silabs-CongD/z_wave_test/.github/project_info/README.md

# This folder will save information of the projects #

# Guide for TOC Hardware driver
    # Hardware driver
    toc_data['detail_name'] = 'your_input'
    toc_data['hw_driver_class'] = ''
    toc_data['third_party_board'] = ''
    toc_data['application_example'] = 'your_input'

# Guide for TOC Wireless Use case and TOC Market segment
    # Wireless usecase
    toc_data['detail_name'] = 'your_input'
    toc_data['embed_to_embed'] = 'Yes/No'
    toc_data['embed_to_gw'] = 'Yes/No'
    toc_data['embed_to_mobile'] = 'Yes/No'
    toc_data['wireless_tech'] = ''

    # Market segment
    toc_data['application'] = 'your_input'
    toc_data['market_segment'] = 'your_input'
