silabs-CongD/z_wave_test/z_wave_contact_sensor_application/docs/ZGM130S-SENSORS_DESIGN/Schematic/ZGM130-SENSORS_DESIGN_BOM.xlsx

ZGM130S based Contact Sensor Reference Design Revised: Friday, April 05, 2019
Revision: 1.0
Bill Of Materials April 5,2019 11:14:35
Item | Quantity | Reference | Value | Manufacturer | PartNumber | Footprint | Tolerance | Rating | Type | Not Installed
1 | 1 | ANT1 | ANT1204F005R0915A | Yageo | ANT1204F005R0915A | ANT1204 |  | 1W | ANTENNA
2 | 1 | BH1 | 20mm COIN | HUAI YANG CO., LTD | BS-06-BAA4002 | BAT-HLDR-2032-BS-06-B4AA002 |  |  | BATTERY_HOLDER
3 | 3 | C18 C20 C115 | 0.1uF | Venkel | C0402X7R100-104K | C0402 | ±10% |  | X7R
4 | 1 | C19 | 100uF | Kemet | T491D107K010AT | C7343D | ±10% |  | TANT
5 | 1 | C21 | 0.01uF | MuRata | GRM155R71H103KA88D | C0402 | ±10% |  | X7R
6 | 1 | C22 | 8pF | Venkel | C0402C0G250-8R0CNE | C0402 | ±0.25pF |  | C0G
7 | 1 | C23 | 4.7uF | Venkel | C0603X5R6R3-475K | C0603 | ±10% |  | X5R
8 | 1 | C24 | 56pF | MuRata | GRM1555C1H560GA01D | C0402 | ±2% |  | C0G
9 | 2 | C110 C112 | 10uF | Murata | ZRB18AD71A106KE01L | C0603 | ±10% |  | X7T
10 | 1 | C114 | 0.1uF | Murata | GRM155R71A104KA01D | C0402 | ±10% |  | X7R
11 | 1 | D1 | SUPER RED | EVERLIGHT ELECTRONICS CO.,LTD. | 19-21SURC/S530-XX/TR8 | LED-0603 |  | 25mA | SMT
12 | 1 | J1 | Header 2x5 .05in | Samtec | FTSH-105-01-F-DV-K | CONN2X5-FTS |  |  | Header
13 | 1 | M1 | SSM3J328R,LF | Toshiba | SSM3J328R,LF | SOT23-GSD |  | -6.0A | P-CHNL
14 | 2 | R4 R218 | 120 | Venkel | CR0402-16W-1200F | R0402 | ±1% | 1/16W | ThickFilm
15 | 1 | R5 | 287 | Venkel | CR0402-16W-2870F | R0402 | ±1% | 1/16W | ThickFilm
16 | 1 | R9 | 1K | Venkel | CR0402-16W-1001F | R0402 | ±1% | 1/16W | ThickFilm | NI
17 | 2 | R211 R212 | 0 | Venkel | CR0402-16W-000 | R0402 |  | 1A | ThickFilm | NI
18 | 1 | R214 | 0 | Venkel | CR0402-16W-000 | R0402 |  | 1A | ThickFilm
19 | 2 | R215 R216 | 10K | Venkel | CR0402-16W-103J | R0402 | ±5% | 1/16W | ThickFilm
20 | 1 | SW1 | SW_SLIDE_2POS | C&K | AYZ0202AGRLC | SW-DPDT-AYZ0202AGRLC |  | 100mA @ 12V | SLIDE
21 | 1 | SW2 | SW REED-NO | RYAZAN METAL CERAMICS INSTRUMENTAYION PLANT, JSC | MKA-14103 | SW-MKA-14103 |  | 500mA | REED | NI
22 | 1 | S1 | DS-A40-AU | Dawning Precision Co.,Ltd | DS-A40-AU | SW-DS-A40 |  | 1mA | Detector switch
23 | 1 | S2 | TS-A00-2-S076 | Dawning Precision Co., Ltd | TS-A00-2-S076 | SW-TS-A00-2-S076 |  | 50mA | Tactile
24 | 11 | TP1 TP11 TP12 TP13 TP14 TP15 TP16 TP17 TP18 TP25 TP0 | TPV | N/A | N/A | VIA-TP |  |  | PCB Feature
25 | 1 | U4 | Si7021 | SiLabs | SI7021-A20-IM1 | DFN6M3X3P1.0E |  |  | Humidity and Temperature
26 | 1 | U5 | ZGM130S037HGN1 | SiLabs | ZGM130S037HGN1R | LGA64M9X9P0.5 |  |  | MCU
27 | 1 | U6 | Si7210-B-00 | SiLabs | Si7210-B-00-IV(R) | SOT5N2.8P0.95 |  |  | Hall Effect
