silabs-CongD/z_wave_test/z_wave_contact_sensor_application/docs/ZGM130S-SENSORS_DESIGN/Schematic/zgm130s-sensors_design2.pdf

Initial design.

# Revision History

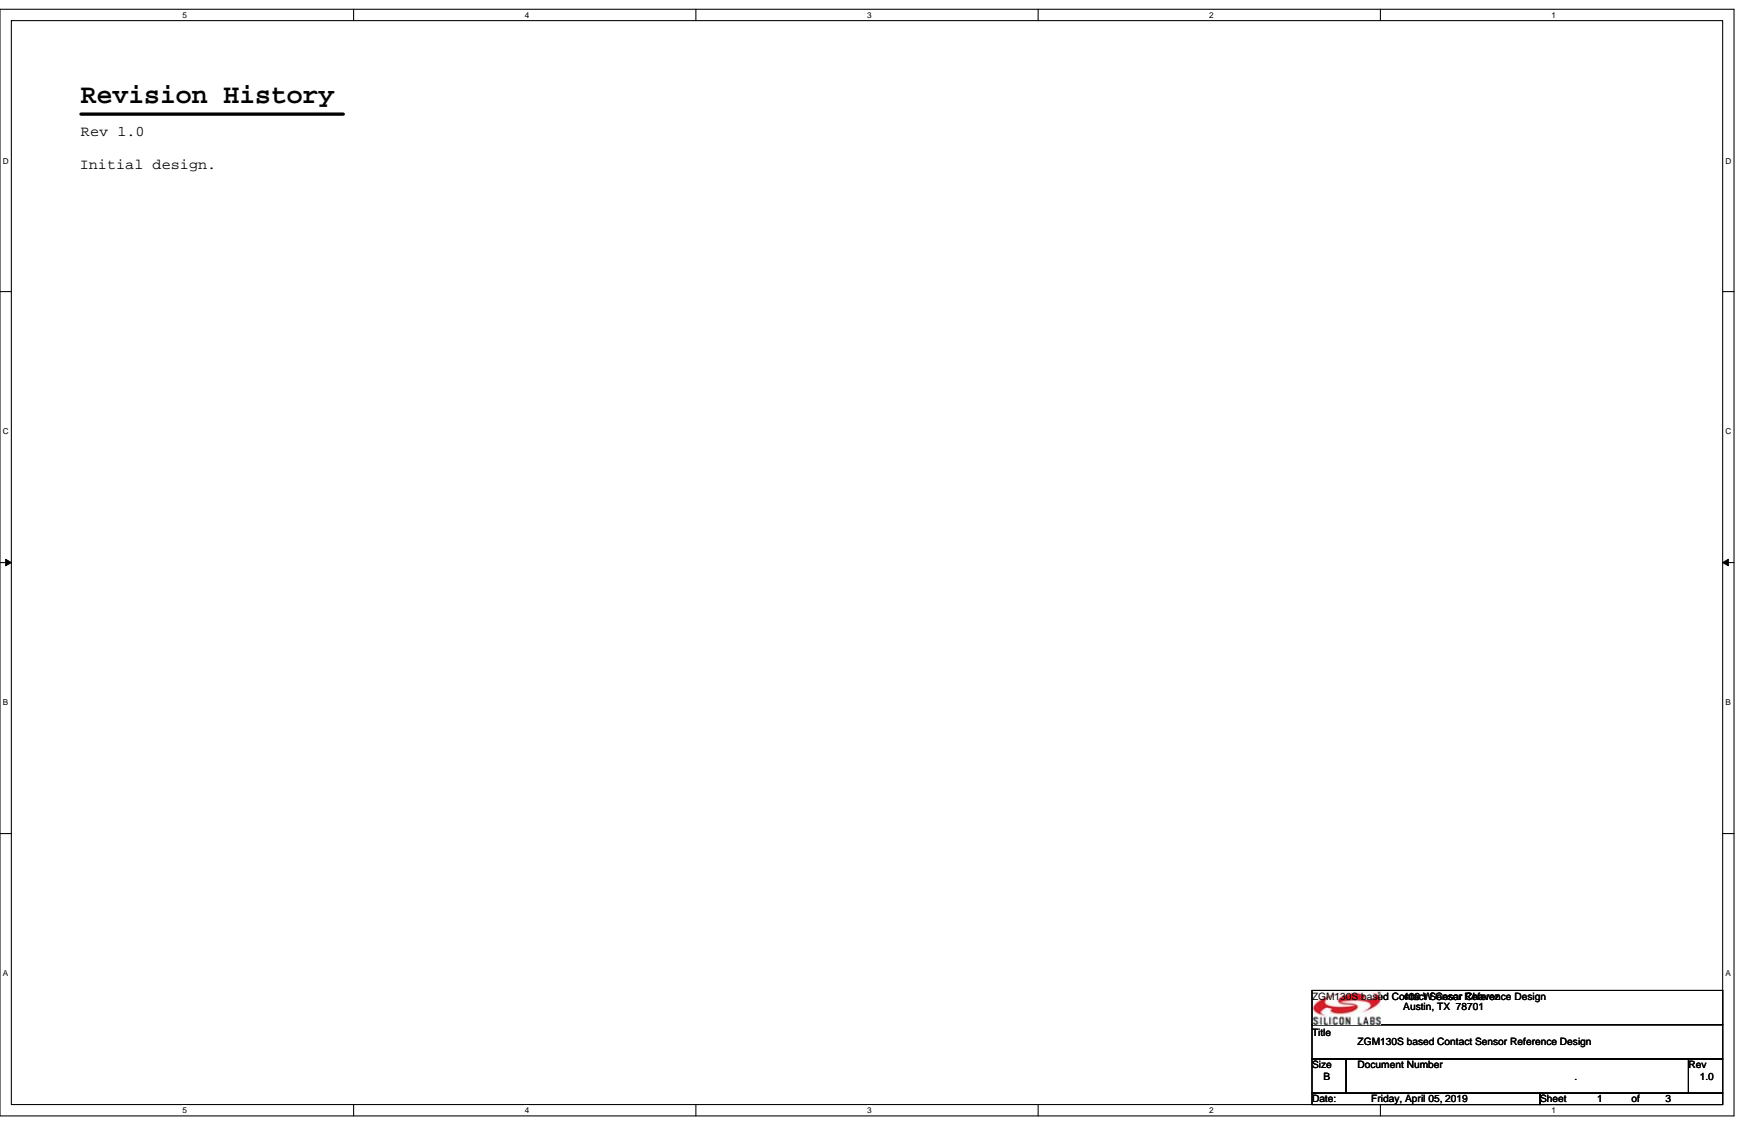
[picture p5: page 1]
Rev 1.0; Title; 400 W Cesar Chavez Austin, TX 78701

ZGM130S based Contact Sensor Reference Design

Size Size Size B B B | Document Number Document Number Document Number . . . | Rev Rev Rev 1.0 1.0 1.0

Date: Date: Date: Friday, April 05, 2019 Friday, April 05, 2019 Friday, April 05, 2019 | Sheet Sheet Sheet 1 1 1 of of of 3 3 3

## Chip Antenna

I/O Port Pins | Antenna & Radio Interface

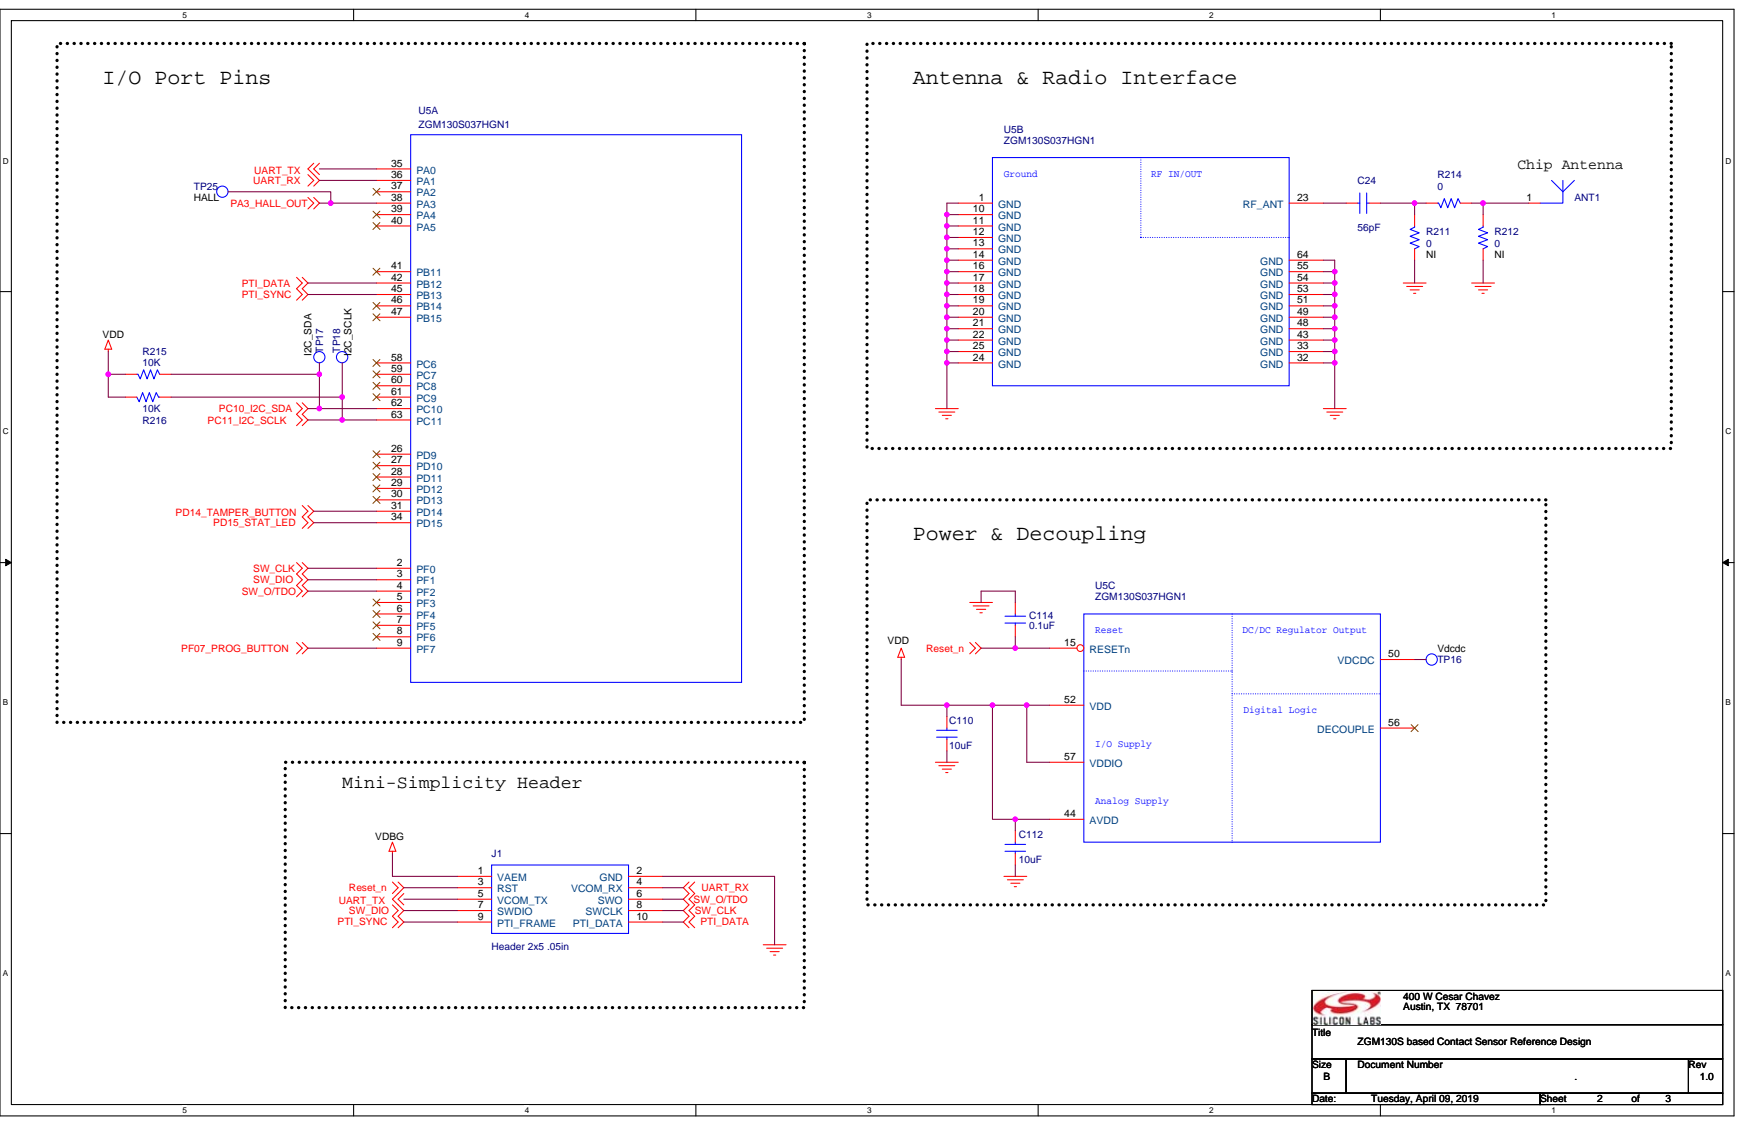
[picture p6: page 2]

DC/DC Regulator Output

ZGM130S based Contact Sensor Reference Design

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

Date: Date: Date: Tuesday, April 09, 2019 Tuesday, April 09, 2019 Tuesday, April 09, 2019 | Sheet Sheet Sheet 2 2 2 of of of 3 3 3

## Power Source Selection Switch

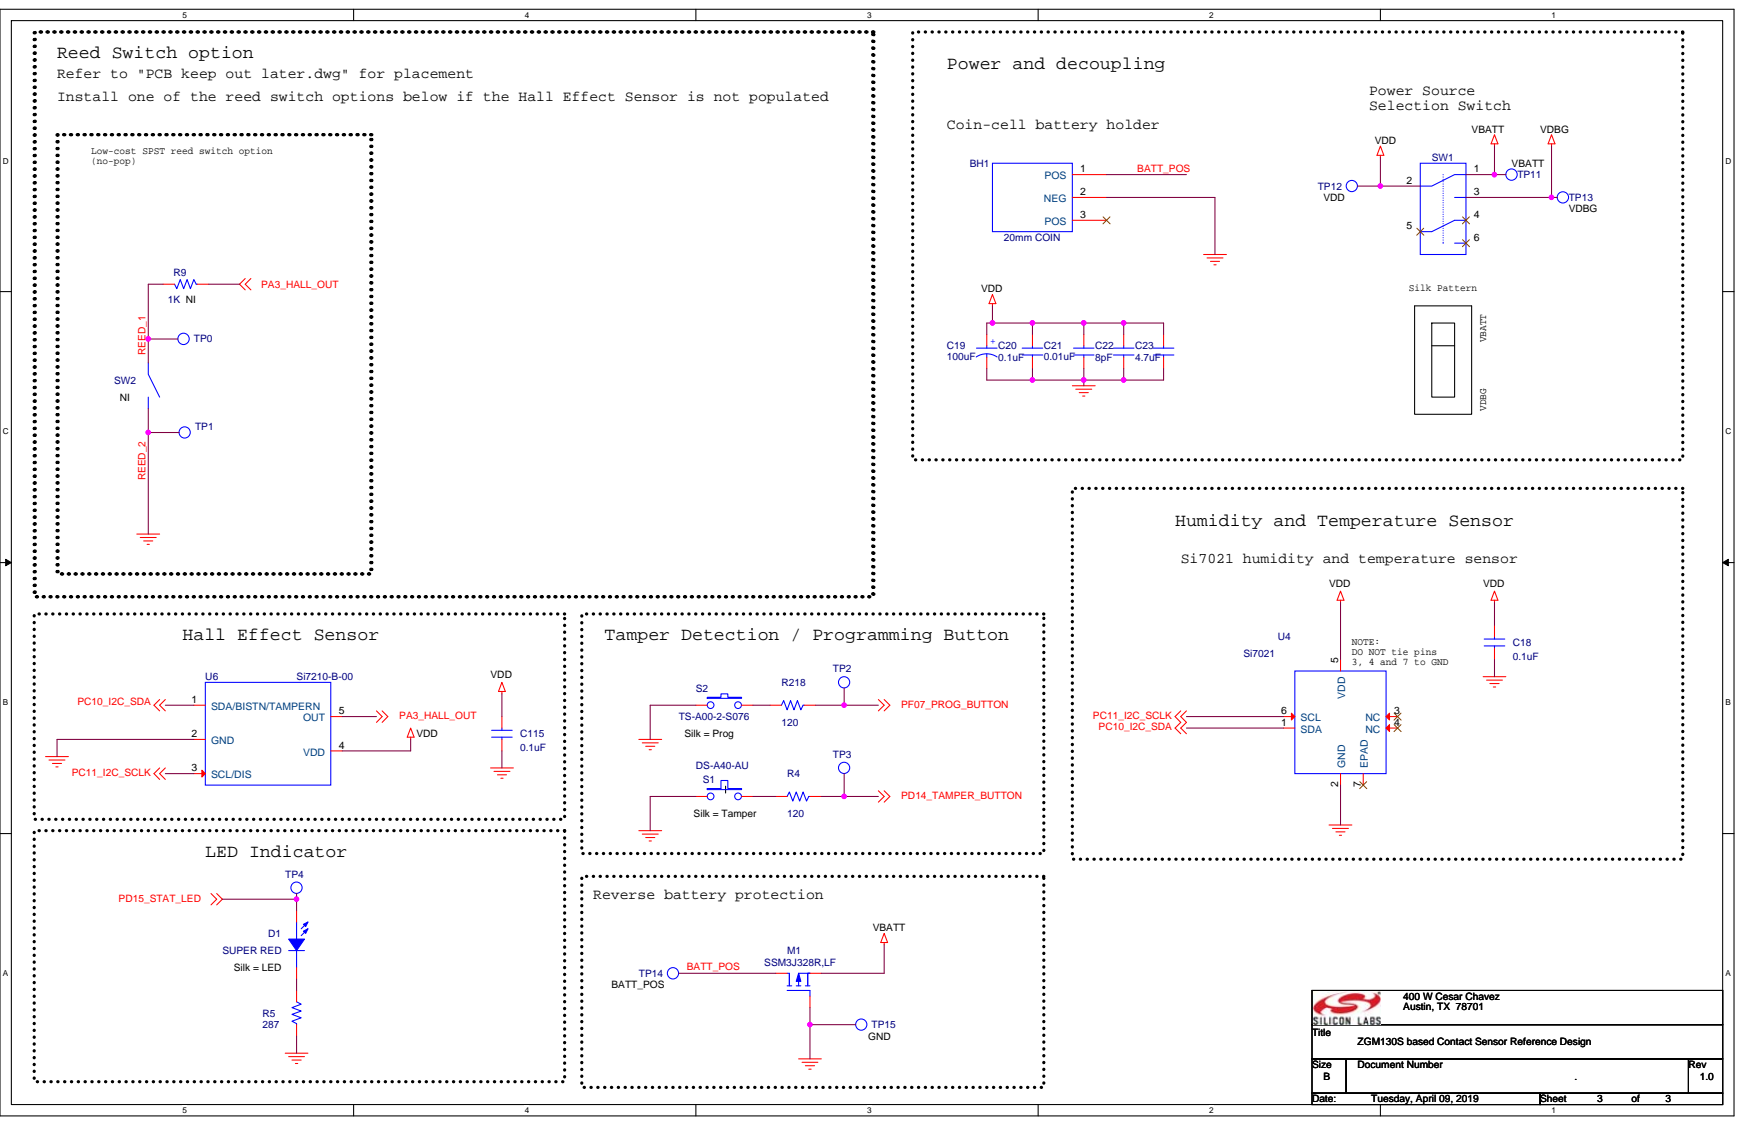
[picture p7: page 3]

Reed Switch option
Refer to "PCB keep out later.dwg" for placement
Install one of the reed switch options below if the Hall Effect Sensor is not populated

Coin-cell battery holder

Low-cost SPST reed switch option
(no-pop)

Humidity and Temperature Sensor

Si7021 humidity and temperature sensor

NOTE:
DO NOT tie pins
3, 4 and 7 to GND

Reverse battery protection | VBATT

ZGM130S based Contact Sensor Reference Design

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

Date: Date: Date: Tuesday, April 09, 2019 Tuesday, April 09, 2019 Tuesday, April 09, 2019 | Sheet Sheet Sheet 3 3 3 of of of 3 3 3
