silabs-CongD/z_wave_test/(list of files, drawings)

Other design files:
z_wave_contact_sensor_application/docs/ZGM130S-SENSORS_DESIGN/Layout/Old/ZGM130S-SENSORS_DESIGN2_30x50.pcb
z_wave_contact_sensor_application/docs/ZGM130S-SENSORS_DESIGN/Layout/ZGM130S-SENSORS_DESIGN.pcb
z_wave_contact_sensor_application/docs/ZGM130S-SENSORS_DESIGN/Layout/ZGM130S-SENSORS_DESIGN_PCBAntenna.pcb
z_wave_contact_sensor_application/docs/ZGM130S-SENSORS_DESIGN/Schematic/ZGM130S-Sensors_design2.DSN
z_wave_contact_sensor_application/docs/ZGM130S-SENSORS_DESIGN/Schematic/zgm130s-sensors_design2.opj
