silabs-CongD/z_wave_test/z_wave_contact_sensor_application/src/config_rf.h

/**
 * @file
 * @brief RF Configuration file for Sensor PIR sample application.
 * @details This file contains RF definitions for the Z-Wave sample app.
 * @copyright 2019 Silicon Laboratories Inc.
 */
#ifndef _CONFIG_RF_H_
#define _CONFIG_RF_H_

// The maximum allowed Tx power in deci dBm
#define APP_MAX_TX_POWER      0

// The deci dBm output measured at a PA setting of 0dBm (raw value 24)
#define APP_MEASURED_0DBM_TX_POWER 33

#endif /* _CONFIG_RF_H_ */
