silabs-CongD/z_wave_test/(notices)

Notices in the files:
z_wave_contact_sensor_application/README.md:
License: Zlib
